manidip-m/greenhouse-arduino-light-temp/(commit log)

2026-10-06 Add Arduino sketch and 26 Feb sample data
    [arduino_readings_2025-02-26.csv]
2026-10-06 Revised file information for tutorial
    [arduino_readings_2025-02-14.csv, arduino_readings_2025-02-26.csv]
